hhhlau/sd5524-tangible-interaction/system1_character/readme.md

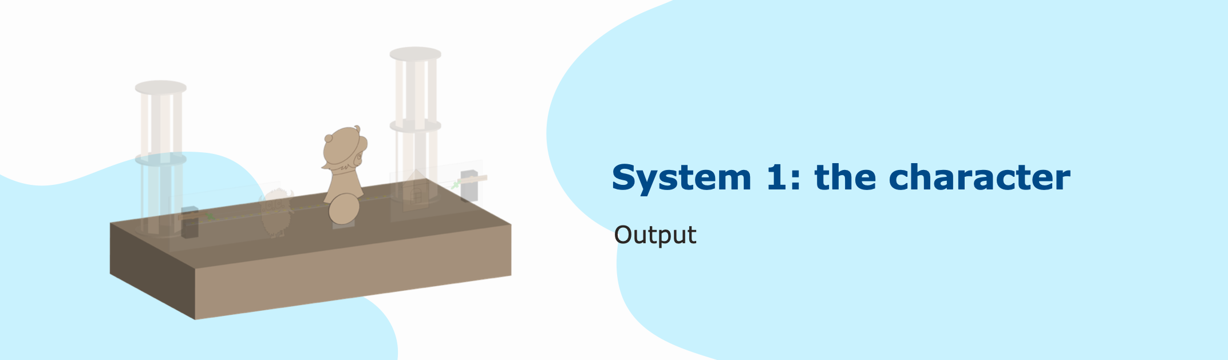
[picture p12: system1_character/resources/cover.png]
System 1 cover

# System 1: The Character

## Descpription
As one of the outputs, mapping with the user's steps' speed on the input board. The disc represents running movement. The rotating speed of the disc is based on the user's steps. With more steps on the board, the disc will rotate faster. Meanwhile, the character also has three inclination angles, involved with standing, walking and running.

## Materials and resources
### Electronics
| Item | ID (if any) | Quantities | Purpose | Where to get |
| ---- | :---: | :---: | --- | --- |
| 180 Servo motor | MG996 | 1 | Control the inclination of the character | [Taobao](https://item.taobao.com/item.htm?spm=a312a.7700824.w4002-23304424597.26.7e839d8aDol6Ct&id=581652733065) |
| Small DC motor (from kit) | / | 1 | For the motor of the character feet | [Taobao](https://item.taobao.com/item.htm?id=568426498725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) |
| NodeMCU v1 | ESP 8266 | 1 | Controlling the hardwares with wireless compability | [Taobao](https://detail.tmall.com/item.htm?id=606082163513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)
| DC Motor shield | L298N | 1 (_share use with system 3_) | Allow speed control and direction control for 2 DC motors | [Taobao](https://detail.tmall.com/item.htm?spm=a230r.1.14.23.53526f0dTKTMPP&id=18566053714&ns=1&abbucket=18)

### Laser cut 
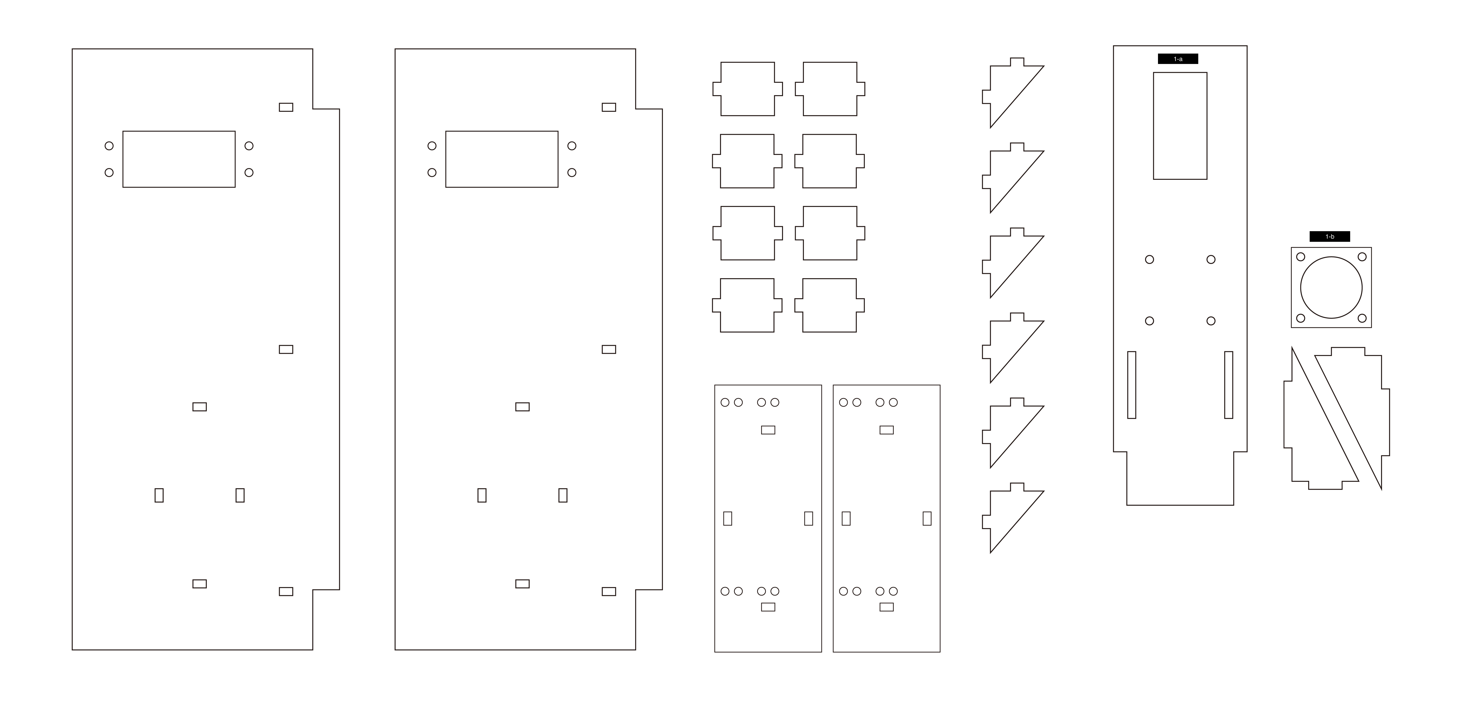
[picture p13: system1_character/resources/laser-cut.jpg]
System 1 Laser cut schematic

Material: **3mm clear acrylic**

File: [download](./resources/Supporting.ai) **Sharing MDF with System 4**

### Steps to assemble
1. Put the Servo motor though the rectagular opening on parts _1-a_, fix the servo motor with 3mm screws and nuts
2. Mount the small DC motor on the motor mounting plate (parts _1-b_), apply glue if needed
3. Put the motor mounting plate on the _1-a_ with screws
4. Make sure all the wires are running at the back of _1-a_ and long enough to run though the opening on the stage, extend the wires if needed
5. Test the system by deploying the code and controls as below

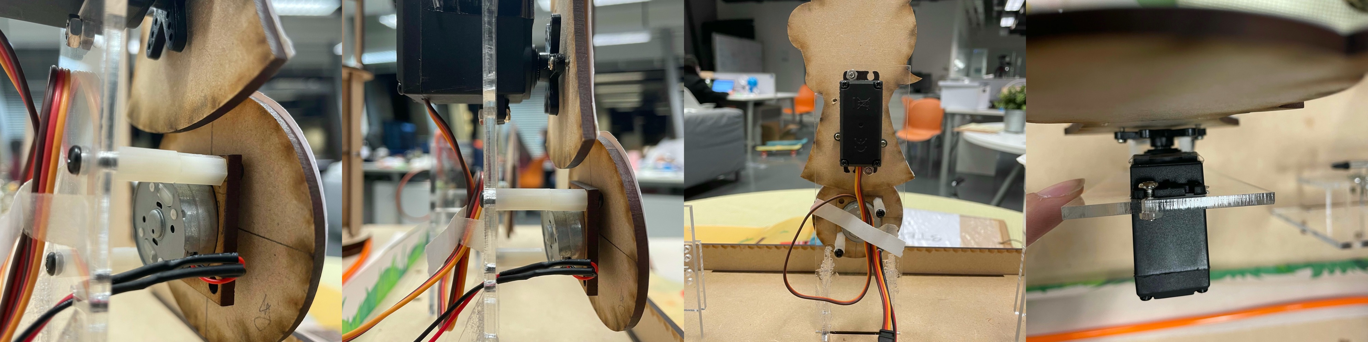
[picture p14: system1_character/resources/collage1.jpeg]

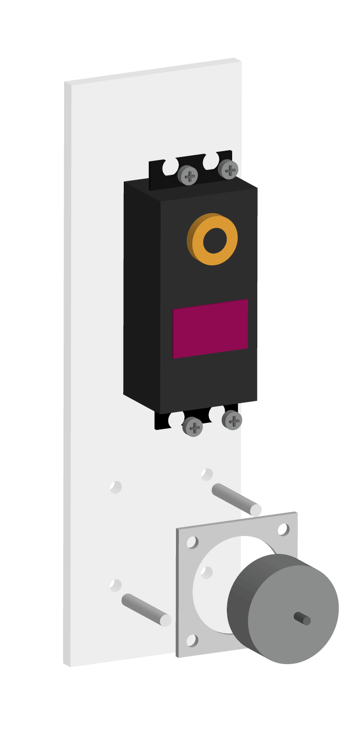
[picture p15: system1_character/resources/install.PNG]


## Wiring
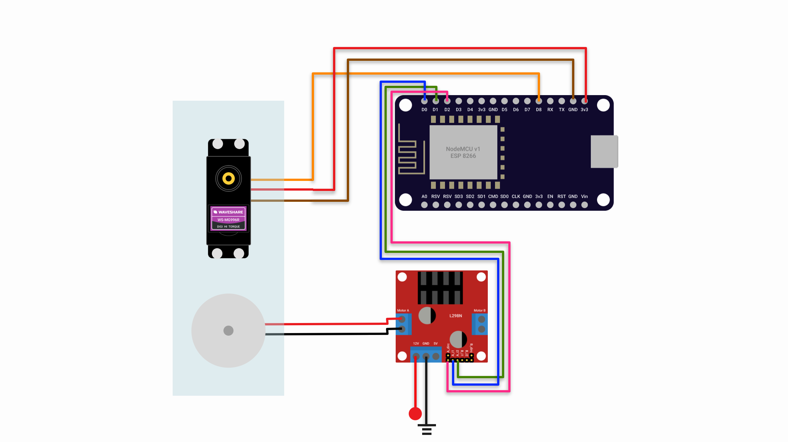
[picture p16: system1_character/resources/wiring.png]
Wiring for system 1

| pin (ESP 82866) | Connection |
| --- | --- |
| D8 | Servo motor signal (Orange) |
| D0 | Motor A signal pin 1 (L298N) |
| D1 | Motor A signal pin 1 (L298N) |
| D2 | Motor A Speed control pin (L298N) _* need to remove the jumper_ |

## Software
For details, please reference to the comments in [sys1.ino](sys1/sys1.ino). For the first time deploy, please be remained to update the Wifi connection, Device ID and MQTT broker endpoint.
### Controls (subcribing)
1. Turn the character to an angle value : `{device_id}/turn`

    #### payload 
    - servoId: Integer ( 0 - 8 )
    - angle: Integer (0 - 180 )

    #### example
    ```JSON
    {
      "servoId": 0,
      "angle": 90 
     }
    ```
2. To make the character run : `{device_id}/run`
   
    #### payload
      - speed: Integer ( 0 - 1023, default= 550 ) 
      - isClockwise: BOOL (default= true)

    #### example payload
    ```JSON
    // To set the motor 0 with speed 500 in clockwise
    {
      "motorId": 0,
      "speed": 500,
      "isClockwise": true
    }
    ```
