hhhlau/sd5524-tangible-interaction/(commit log)

2021-01-21 Workable Velostat sample code
2021-01-21 Basic structure for support custom action
    - Implemented Servo as example
2021-02-04 To support controlling multi servo with one 8266
2021-02-13 Updated - /turn added hard code mapping on servo[1] to D7
2021-02-13 Added - System 1 /turn: to turn the character to an angle /run: to spin character leg
2021-02-15 added socketio for 2 way comm.
2021-02-16 Testing on using arduino mirco as analog controller
2021-02-16 bug fixed on control brightness
    [sys3.ino]
2021-02-16 Fixed missing init pin actions for servo 1
    [sys4.ino]
2021-02-17 - Added socketIO listener for frontend - added character & stage scene handlers - bug fixs
    [systemHandler.js]
2021-02-18 update MQTT broker endpoint
    [sys1.ino, sys2.ino, sys3.ino, sys4.ino]
2021-02-18 fine tuning the para
2021-02-19 - fix the stage not rendering base on the interval - updating logs
    [systemHandler.js]
